tixlegeek/CoolKidsBadge-2024/fw/scripts/createCerts/README.md

# CoolKidsBadge: createCerts

## NAME

CoolKid'sBadge ESP32 SSL Cert generator

## SYNOPSIS

| **ssl_cert_gen.sh**

## DESCRIPTION

Create a set of cert files aimed to be used inside ESP32 HTTPD code.

## FILES

-  **./certs/prvtkey.pem** : private_key

- **./certs/servercert.pem** : certificate

- **./ssl_cert_gen.conf** : Cert configuration file

## ENVIRONMENT

## BUGS

> [!NOTE]
>
> ToDo: Add github repoaddress and bug reporting information

## AUTHOR

@tixlegeek [tixlegeek@cyberpunk.company](mailto:tixlegeek@cyberpunk.company)

## SEE ALSO
