tixlegeek/CoolKidsBadge-2024/hw/CoolKidsBadge_PCB.stl

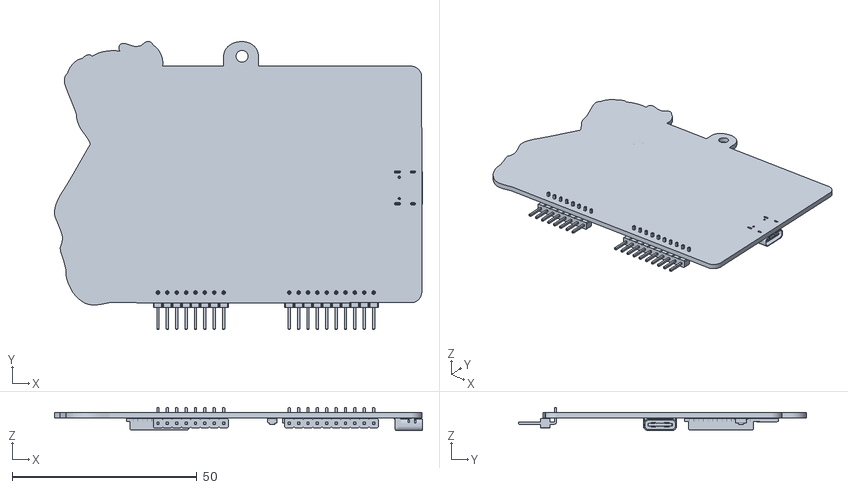
[picture p4: CAD file, 2024-09-17]
hw/CoolKidsBadge_PCB.stl
99.7 x 78.1 x 6.31
