tixlegeek/CoolKidsBadge-2024/hw/kicad_schematics/CIRCLE.kicad_sch

## KiCad design hw/kicad_schematics/CIRCLE.kicad_sch (2024-07-31)

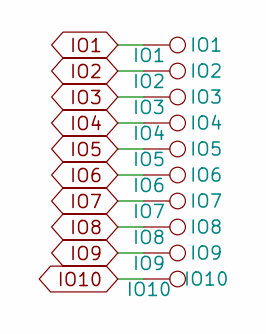
[picture p9: schematic CIRCLE.kicad_sch]

Parts:
IO1: IO1; TestPoint_Pad_D2.0mm
IO2: IO2; TestPoint_Pad_D2.0mm
IO3: IO3; TestPoint_Pad_D2.0mm
IO4: IO4; TestPoint_Pad_D2.0mm
IO5: IO5; TestPoint_Pad_D2.0mm
IO6: IO6; TestPoint_Pad_D2.0mm
IO7: IO7; TestPoint_Pad_D2.0mm
IO8: IO8; TestPoint_Pad_D2.0mm
IO9: IO9; TestPoint_Pad_D2.0mm
IO10: IO10; TestPoint_Pad_D2.0mm

Connections:
IO1: IO1.1
IO2: IO2.1
IO3: IO3.1
IO4: IO4.1
IO5: IO5.1
IO6: IO6.1
IO7: IO7.1
IO8: IO8.1
IO9: IO9.1
IO10: IO10.1
