tixlegeek/CoolKidsBadge-2024/hw/kicad_schematics/CoolKidsBadge.kicad_sch

## KiCad design hw/kicad_schematics/CoolKidsBadge.kicad_sch (2024-07-31)

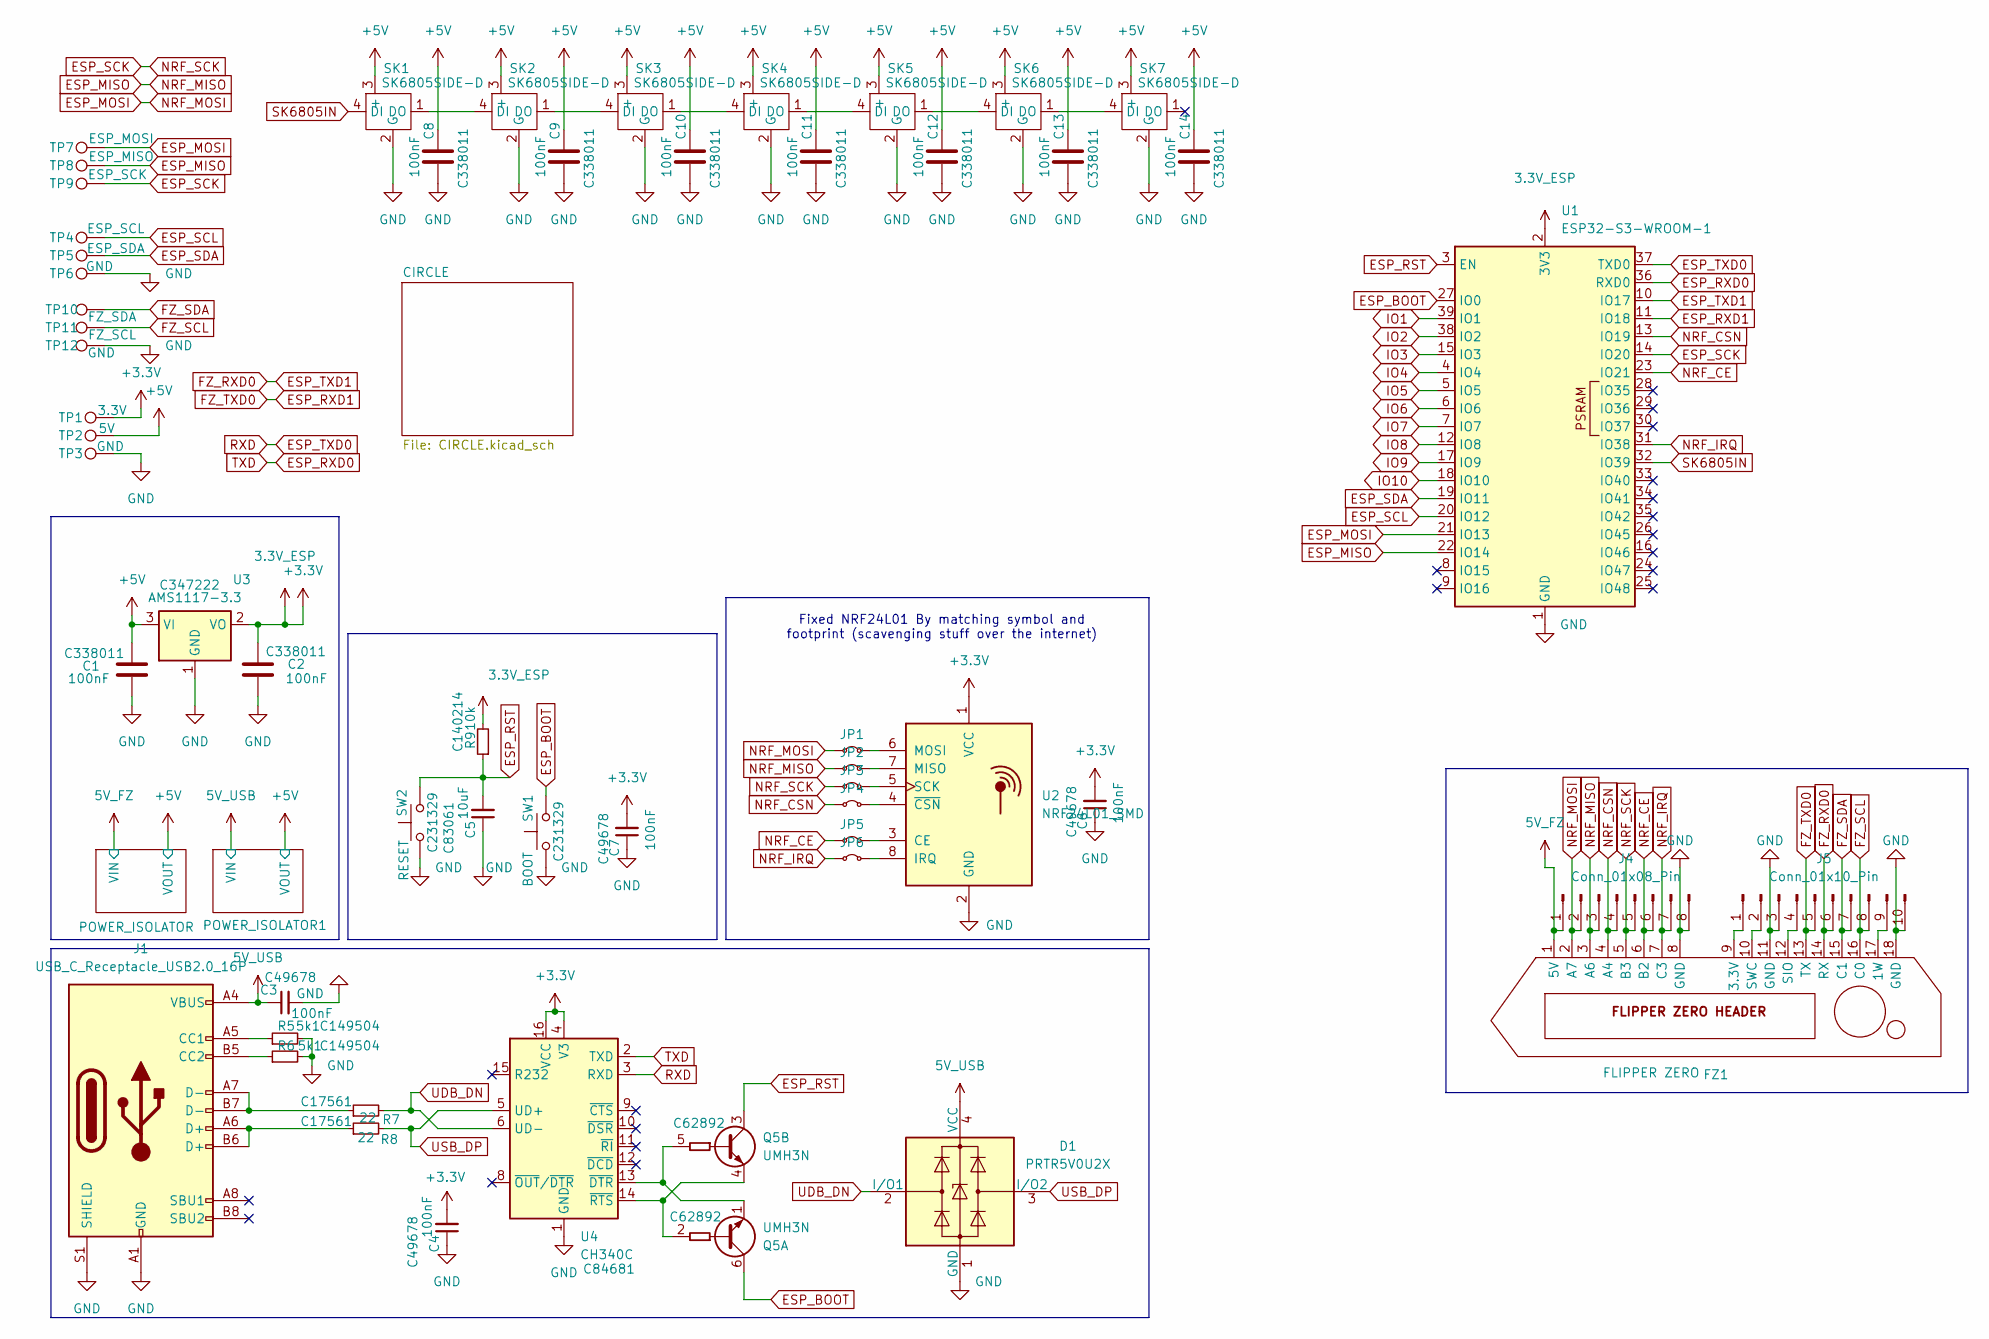
[picture p10: schematic CoolKidsBadge.kicad_sch]

Parts:
C1, C2, C8, C9, C10, C11, C12, C13, C14: 100nF; C_0402_1005Metric; JLCPCB C338011
C3, C4, C6, C7: 100nF; C_0805_2012Metric; JLCPCB C49678
C5: 10uF; C_0805_2012Metric; JLCPCB C83061
D1: PRTR5V0U2X; SOT-143; JLCPCB C5158049
FZ1: FLIPPER ZERO; FLIPPER_ZERO_HEADER
J1: USB_C_Receptacle_USB2.0_16P; USB_C_Receptacle_GCT_USB4105-xx-A_16P_TopMnt_Horizontal
J4: Conn_01x08_Pin; PinHeader_1x08_P2.54mm_Horizontal
J5: Conn_01x10_Pin; PinHeader_1x10_P2.54mm_Horizontal
JP1, JP2, JP3, JP4, JP5, JP6: Jumper_2_Small_Bridged; SolderJumper-2_P1.3mm_Bridged_RoundedPad1.0x1.5mm
Q5: UMH3N; SOT-363_SC-70-6; JLCPCB C62892
R5, R6: 5k1; R_0805_2012Metric; JLCPCB C149504
R7, R8: 22; R_0805_2012Metric; JLCPCB C17561
R9: 10k; R_0805_2012Metric; JLCPCB C140214
SK1, SK2, SK3, SK4, SK5, SK6, SK7: SK6805SIDE-D
SW1: BOOT; SW_SPST_B3U-1000P; JLCPCB C231329
SW2: RESET; SW_SPST_B3U-1000P; JLCPCB C231329
TP1: 3.3V; TestPoint_Pad_D2.5mm
TP2: 5V; TestPoint_Pad_D2.5mm
TP3, TP6, TP12: GND; TestPoint_Pad_D2.5mm
TP4: ESP_SCL; TestPoint_Pad_D2.5mm
TP5: ESP_SDA; TestPoint_Pad_D2.5mm
TP7: ESP_MOSI; TestPoint_Pad_D2.5mm
TP8: ESP_MISO; TestPoint_Pad_D2.5mm
TP9: ESP_SCK; TestPoint_Pad_D2.5mm
TP10: FZ_SDA; TestPoint_Pad_D2.5mm
TP11: FZ_SCL; TestPoint_Pad_D2.5mm
U1: ESP32-S3-WROOM-1
U2: NRF24L01_SMD; NRF24L01-Module-SMD
U3: AMS1117-3.3; SOT-223-3_TabPin2; JLCPCB C347222
U4: CH340C; SOIC-16_3.9x9.9mm_P1.27mm; JLCPCB C84681

Connections:
5V_FZ: FZ1.1 (5V), J4.1
5V_USB: C3.1, D1.4 (VCC), J1.A4 (VBUS), J1.A9 (VBUS), J1.B4 (VBUS), J1.B9 (VBUS)
+3.3V: C2.1, C4.2, C6.2, C7.2, R9.2, TP1.1, U1.2 (3V3), U2.1 (VCC), U3.2 (VO), U4.4 (V3), U4.16 (VCC)
+5V: C1.1, C8.1, C9.1, C10.1, C11.1, C12.1, C13.1, C14.1, SK1.3 (+), SK2.3 (+), SK3.3 (+), SK4.3 (+), SK5.3 (+), SK6.3 (+), SK7.3 (+), TP2.1, U3.3 (VI)
ESP_BOOT: Q5.6 (C1), SW1.2, U1.27 (IO0)
ESP_MISO: FZ1.3 (A6), J4.3, JP2.1 (A), TP8.1, U1.22 (IO14)
ESP_MOSI: FZ1.2 (A7), J4.2, JP1.1 (A), TP7.1, U1.21 (IO13)
ESP_RST: C5.2, Q5.3 (C2), R9.1, SW2.2, U1.3 (EN)
ESP_RXD0: U1.36 (RXD0), U4.2 (TXD)
ESP_RXD1: FZ1.13 (TX), J5.5, U1.11 (IO18)
ESP_SCK: FZ1.5 (B3), J4.5, JP3.1 (A), TP9.1, U1.14 (IO20)
ESP_SCL: TP4.1, U1.20 (IO12)
ESP_SDA: TP5.1, U1.19 (IO11)
ESP_TXD0: U1.37 (TXD0), U4.3 (RXD)
ESP_TXD1: FZ1.14 (RX), J5.6, U1.10 (IO17)
FZ_SCL: FZ1.16 (C0), J5.8, TP11.1
FZ_SDA: FZ1.15 (C1), J5.7, TP10.1
GND: C1.2, C2.2, C3.2, C4.1, C5.1, C6.1, C7.1, C8.2, C9.2, C10.2, C11.2, C12.2, C13.2, C14.2, D1.1 (GND), FZ1.8 (GND), FZ1.11 (GND), FZ1.18 (GND), J1.A1 (GND), J1.A12 (GND), J1.B1 (GND), J1.B12 (GND), J1.S1 (SHIELD), J4.8, J5.3, J5.10, R5.2, R6.2, SK1.2 (G), SK2.2 (G), SK3.2 (G), SK4.2 (G), SK5.2 (G), SK6.2 (G), SK7.2 (G), SW1.1, SW2.1, TP3.1, TP6.1, TP12.1, U1.1 (GND), U1.40 (GND), U1.41 (GND), U2.2 (GND), U3.1 (GND), U4.1 (GND)
IO1: U1.39 (IO1)
IO2: U1.38 (IO2)
IO3: U1.15 (IO3)
IO4: U1.4 (IO4)
IO5: U1.5 (IO5)
IO6: U1.6 (IO6)
IO7: U1.7 (IO7)
IO8: U1.12 (IO8)
IO9: U1.17 (IO9)
IO10: U1.18 (IO10)
NRF_CE: FZ1.6 (B2), J4.6, JP5.1 (A), U1.23 (IO21)
NRF_CSN: FZ1.4 (A4), J4.4, JP4.1 (A), U1.13 (IO19)
NRF_IRQ: FZ1.7 (C3), J4.7, JP6.1 (A), U1.31 (IO38)
unnamed: FZ1.9 (3.3V), J5.1
unnamed: FZ1.10 (SWC), J5.2
unnamed: FZ1.12 (SIO), J5.4
unnamed: FZ1.17 (1W), J5.9
unnamed: J1.A5 (CC1), R5.1
unnamed: J1.A6 (D+), J1.B6 (D+), R8.1
unnamed: J1.A7 (D-), J1.B7 (D-), R7.1
unnamed: J1.B5 (CC2), R6.1
unnamed: JP1.2 (B), U2.6 (MOSI)
unnamed: JP2.2 (B), U2.7 (MISO)
unnamed: JP3.2 (B), U2.5 (SCK)
unnamed: JP4.2 (B), U2.4 (~CSN)
unnamed: JP5.2 (B), U2.3 (CE)
unnamed: JP6.2 (B), U2.8 (IRQ)
unnamed: Q5.1 (E1), Q5.5 (B2), U4.13 (~DTR)
unnamed: Q5.2 (B1), Q5.4 (E2), U4.14 (~RTS)
unnamed: SK1.1 (DO), SK2.4 (DI)
unnamed: SK2.1 (DO), SK3.4 (DI)
unnamed: SK3.1 (DO), SK4.4 (DI)
unnamed: SK4.1 (DO), SK5.4 (DI)
unnamed: SK5.1 (DO), SK6.4 (DI)
unnamed: SK6.1 (DO), SK7.4 (DI)
SK6805IN: SK1.4 (DI), U1.32 (IO39)
UDB_DN: D1.2 (I/O1), R7.2, U4.6 (UD-)
USB_DP: D1.3 (I/O2), R8.2, U4.5 (UD+)

Notes on the sheet:
Fixed NRF24L01 By matching symbol and footprint (scavenging stuff over the internet)
