tixlegeek/CoolKidsBadge-2024/hw/kicad_schematics/POWER_ISOLATOR.kicad_sch

## KiCad design hw/kicad_schematics/POWER_ISOLATOR.kicad_sch (2024-07-31)

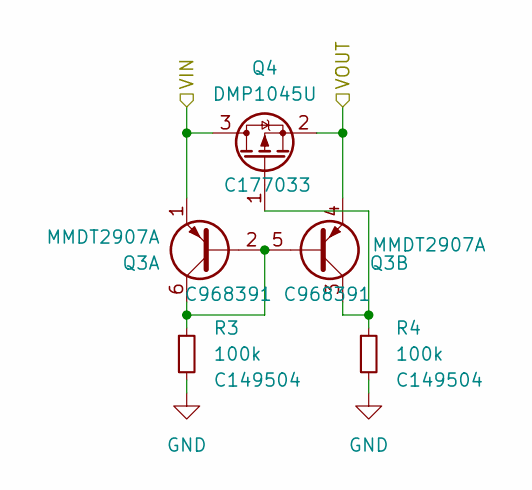
[picture p11: schematic POWER_ISOLATOR.kicad_sch]

Parts:
Q3: MMDT2907A; SOT-363_SC-70-6; JLCPCB C968391
Q4: DMP1045U; SOT-23; JLCPCB C177033
R3, R4: 100k; R_0805_2012Metric; JLCPCB C149504

Connections:
GND: R3.2, R4.2
unnamed: Q3.2 (B1), Q3.5 (B2), Q3.6 (C1), R3.1
unnamed: Q3.3 (C2), Q4.1 (G), R4.1
VIN: Q3.1 (E1), Q4.3 (D)
VOUT: Q3.4 (E2), Q4.2 (S)
