tixlegeek/CoolKidsBadge-2024/fw/esp32/main/board.h

/** -------------------------------------------------------
 *  ▞▚ ▚▗▘▛▚ ▛▀ ▛▚ ▛▚ ▌▐ ▙▐ ▌▞  ▞▚ ▞▚ ▙▟ ▛▚ ▞▚ ▙▐ ▚▗▘
 *  ▌▗  ▌ ▛▚ ▛  ▛▚ ▛▘ ▌▐ ▌▜ ▛▖  ▌▗ ▌▐ ▌▐ ▛▘ ▛▜ ▌▜  ▌
 *  ▝▘  ▘ ▀▘ ▀▀ ▘▝ ▘  ▝▘ ▘▝ ▘▝ ▘▝▘ ▝▘ ▘▝ ▘  ▘▝ ▘▝  ▘
 * Copyright© 2024 - Cyberpunk.Company - GPLv3
 * This program is free software
 * See LICENSE.txt - https://cyberpunk.company/tixlegeek
 * -------------------------------------------------------**/

#ifndef _BOARD_H_
#define _BOARD_H_

#include "esp_log.h"

#include "driver/i2c_master.h"

#define BOARD_I2C_SDA 11
#define BOARD_I2C_SCL 12

#define BOARD_LED_NUMBERS 7
#define BOARD_LED_GPIO_NUM 39

#define LED_STRIP_RESOLUTION_HZ 10000000

#define I2C_MASTER_NUM I2C_NUM_0
#define I2C_MASTER_FREQ_HZ 400000   /*!< I2C master clock frequency */
#define I2C_MASTER_TX_BUF_DISABLE 0 /*!< I2C master doesn't need buffer */
#define I2C_MASTER_RX_BUF_DISABLE 0 /*!< I2C master doesn't need buffer */
#define I2C_MASTER_TIMEOUT_MS 500
#define I2C_MASTER_FREQ_HZ
#define I2C_MAX_REG_READ 1024

#endif /* end of include guard: _BOARD_H_ */
