tixlegeek/CoolKidsBadge-2024/fw/esp32/main/led.c

/** -------------------------------------------------------
 *  ▞▚ ▚▗▘▛▚ ▛▀ ▛▚ ▛▚ ▌▐ ▙▐ ▌▞  ▞▚ ▞▚ ▙▟ ▛▚ ▞▚ ▙▐ ▚▗▘
 *  ▌▗  ▌ ▛▚ ▛  ▛▚ ▛▘ ▌▐ ▌▜ ▛▖  ▌▗ ▌▐ ▌▐ ▛▘ ▛▜ ▌▜  ▌
 *  ▝▘  ▘ ▀▘ ▀▀ ▘▝ ▘  ▝▘ ▘▝ ▘▝ ▘▝▘ ▝▘ ▘▝ ▘  ▘▝ ▘▝  ▘
 * Copyright© 2024 - Cyberpunk.Company - GPLv3
 * This program is free software
 * See LICENSE.txt - https://cyberpunk.company/tixlegeek
 * -------------------------------------------------------**/

#include "led.h"
#include "coolkids.h"
static const char *TAG = "LED";
// Text labels
const uint8_t fire_palette[] = {
  0xff, 0xff, 0xff,
  0xff, 0xff, 0xfb,
  0xff, 0xff, 0xf7,
  0xff, 0xff, 0xf3,
  0xff, 0xff, 0xef,
  0xff, 0xff, 0xeb,
  0xff, 0xff, 0xe7,
  0xff, 0xff, 0xe3,
  0xff, 0xff, 0xdf,
  0xff, 0xff, 0xdb,
  0xff, 0xff, 0xd7,
  0xff, 0xff, 0xd3,
  0xff, 0xff, 0xcf,
  0xff, 0xff, 0xcb,
  0xff, 0xff, 0xc7,
  0xff, 0xff, 0xc3,
  0xff, 0xff, 0xbf,
  0xff, 0xff, 0xbb,
  0xff, 0xff, 0xb7,
  0xff, 0xff, 0xb3,
  0xff, 0xff, 0xaf,
  0xff, 0xff, 0xab,
  0xff, 0xff, 0xa7,
  0xff, 0xff, 0xa3,
  0xff, 0xff, 0x9f,
  0xff, 0xff, 0x9b,
  0xff, 0xff, 0x97,
  0xff, 0xff, 0x93,
  0xff, 0xff, 0x8f,
  0xff, 0xff, 0x8b,
  0xff, 0xff, 0x87,
  0xff, 0xff, 0x83,
  0xff, 0xff, 0x7f,
  0xff, 0xff, 0x7b,
  0xff, 0xff, 0x77,
  0xff, 0xff, 0x73,
  0xff, 0xff, 0x6f,
  0xff, 0xff, 0x6b,
  0xff, 0xff, 0x67,
  0xff, 0xff, 0x63,
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
};
// Names of the animations
const char *const led_cb_name[] = {"rainbow", "green",    "sp4rkle",
                                   "s3cr3t",  "sp1n2W1n", "F1r3"};

// Callbacks
void *led_cb_array[] = {led_rainbow_cb, led_green_cb,    led_sparkle_cb,
                        led_s3cre3t_cb, led_sp1n2W1n_cb, led_fire_cb};

/**
  led_task
  @brief Task that updates the LEDs
  @parms pvParameter -> rgb_led_ctx: RGB Led structure
  @return -
*/
void led_task(void *pvParameter) {
  rgb_led_ctx_t *rgb_led_ctx = (rgb_led_ctx_t *)pvParameter;
  uint32_t t = 0;
  uint8_t shader;
  esp_err_t err;
  err = led_get_saved(&shader);
  if (err != ESP_OK) {
    ESP_LOGE(TAG, "[x] No previous shader configuration set.");
    shader = 0;
  }
  ESP_LOGI(TAG, "[+] LED Task started.");
  ESP_LOGI(TAG, "[+] LED Task calling %s (%d)", led_cb_name[shader], shader);
  while (1) {
    t++;
    led_shader(t, rgb_led_ctx);
    vTaskDelay(10 / portTICK_PERIOD_MS);
  }

  ESP_LOGE(TAG, "[x] LED Task exited.");
}

/**
  led_init
  @brief Initialize RMT and sets up the SK6805 LED chain
  @parms rgb_led_ctx: RGB Led structure
  @return -
*/
void led_init(rgb_led_ctx_t *rgb_led_ctx) {
  uint8_t shader;
  esp_err_t err;
  rgb_led_ctx->tx_chan_config.clk_src =
      RMT_CLK_SRC_DEFAULT; // select source clock
  rgb_led_ctx->tx_chan_config.gpio_num = BOARD_LED_GPIO_NUM;
  rgb_led_ctx->tx_chan_config.mem_block_symbols =
      64; // increase the block size can make the LED less flickering
  rgb_led_ctx->tx_chan_config.resolution_hz = LED_STRIP_RESOLUTION_HZ;
  rgb_led_ctx->tx_chan_config.trans_queue_depth =
      4; // set the number of transactions that can be pending in the background

  rgb_led_ctx->tx_config.loop_count = 0;

  rgb_led_ctx->led_chan = 0;
  rgb_led_ctx->led_encoder = NULL;

  err = led_get_saved(&shader);
  if (err != ESP_OK) {
    ESP_LOGE(TAG, "[x] No previous shader configuration set.");
    shader = 0;
  }

  rgb_led_ctx->led_cb = led_cb_array[shader];

  ESP_ERROR_CHECK(
      rmt_new_tx_channel(&rgb_led_ctx->tx_chan_config, &rgb_led_ctx->led_chan));
  ESP_LOGI(TAG, "[+] Install led strip encoder");

  led_strip_encoder_config_t encoder_config = {
      .resolution = LED_STRIP_RESOLUTION_HZ,
  };

  rgb_led_ctx->led_encoder = NULL;

  ESP_ERROR_CHECK(
      rmt_new_led_strip_encoder(&encoder_config, &rgb_led_ctx->led_encoder));

  ESP_LOGI(TAG, "[+] Enable RMT TX channel");
  ESP_ERROR_CHECK(rmt_enable(rgb_led_ctx->led_chan));
}

/**
  led_commit
  @brief Sends data to the LEDs
  @parms rgb_led_ctx: RGB Led structure
  @return -
*/
void led_commit(rgb_led_ctx_t *rgb_led_ctx, uint8_t *led_strip_pixels) {
  ESP_ERROR_CHECK(rmt_transmit(rgb_led_ctx->led_chan, rgb_led_ctx->led_encoder,
                               led_strip_pixels, BOARD_LED_NUMBERS * 3,
                               &rgb_led_ctx->tx_config));
  ESP_ERROR_CHECK(rmt_tx_wait_all_done(rgb_led_ctx->led_chan, portMAX_DELAY));
}

/**
  led_update
  @brief alias of commit
  @parms rgb_led_ctx: RGB Led structure
  @return -
*/
void led_update(rgb_led_ctx_t *rgb_led_ctx) {
  led_commit(rgb_led_ctx, rgb_led_ctx->led_array);
}

/**

*/
void led_rainbow_cb(uint16_t t, uint8_t ledindex, void *ctx) {
  rgb_led_ctx_t *rgb_led_ctx = (rgb_led_ctx_t *)ctx;
  uint8_t r;
  uint8_t g;
  uint8_t b;
  led_strip_hsv2rgb((t + ledindex * (90 / BOARD_LED_NUMBERS)) % 360, 100, 100,
                    &r, &g, &b);
  rgb_led_ctx->led_array[ledindex * 3 + 0] = g;
  rgb_led_ctx->led_array[ledindex * 3 + 1] = r;
  rgb_led_ctx->led_array[ledindex * 3 + 2] = b;
}

/**

*/
char secretStr[] = CKB_SECRET_PHRASE;

void led_s3cre3t_cb(uint16_t t, uint8_t ledindex, void *ctx) {
  rgb_led_ctx_t *rgb_led_ctx = (rgb_led_ctx_t *)ctx;
  uint16_t offset = t >> 7;
  uint8_t i = 0;
  uint8_t strLen = strlen(secretStr);
  uint8_t strChar = secretStr[offset % strLen];
  uint8_t color = ((strChar >> ledindex) & 0x01) ? 0xFF : 0x00;

  if ((offset % strLen == 0) && (ledindex == 6)) {
    for (i = 0; i < 7; i++) {
      rgb_led_ctx->led_array[i * 3 + 0] = ((t >> 1) % 2 == 0) ? 0xff : 0;
      rgb_led_ctx->led_array[i * 3 + 1] = 0;
      rgb_led_ctx->led_array[i * 3 + 2] = ((t >> 1) % 2 == 0) ? 0x27 : 0;
    }

  } else {
    rgb_led_ctx->led_array[ledindex * 3 + 0] = 0;
    rgb_led_ctx->led_array[ledindex * 3 + 1] = color & 0xff;
    rgb_led_ctx->led_array[ledindex * 3 + 2] = color & 0x27;
  }
}

/**

*/
void led_sp1n2W1n_cb(uint16_t t, uint8_t ledindex, void *ctx) {
  rgb_led_ctx_t *rgb_led_ctx = (rgb_led_ctx_t *)ctx;
  uint8_t r;
  uint8_t g;
  uint8_t b;
  led_strip_hsv2rgb(((t >> 4) * (90 / BOARD_LED_NUMBERS)) % 360, 100, 100, &r,
                    &g, &b);
  bool chekLed = (((ledindex + (t >> 2)) % BOARD_LED_NUMBERS) == 0);
  if (chekLed) {
    rgb_led_ctx->led_array[ledindex * 3 + 0] = g;
    rgb_led_ctx->led_array[ledindex * 3 + 1] = r;
    rgb_led_ctx->led_array[ledindex * 3 + 2] = b;
  } else {
    rgb_led_ctx->led_array[ledindex * 3 + 0] = 0;
    rgb_led_ctx->led_array[ledindex * 3 + 1] = 0;
    rgb_led_ctx->led_array[ledindex * 3 + 2] = 0;
  }
}

/**

*/
void led_fire_cb(uint16_t t, uint8_t ledindex, void *ctx) {
  rgb_led_ctx_t *rgb_led_ctx = (rgb_led_ctx_t *)ctx;
  uint8_t rand = t ^ ledindex;
  rand ^= (rand << 3);
  rand ^= rand >> 5;
  rand ^= rand << 4;
  uint8_t colorindex = (t + ledindex + rand) % 255;
  rgb_led_ctx->led_array[ledindex * 3 + 0] = fire_palette[colorindex*3+1];
  rgb_led_ctx->led_array[ledindex * 3 + 1] = fire_palette[colorindex*3+0];
  rgb_led_ctx->led_array[ledindex * 3 + 2] = fire_palette[colorindex*3+2];
}

/**

*/
void led_sparkle_cb(uint16_t t, uint8_t ledindex, void *ctx) {
  rgb_led_ctx_t *rgb_led_ctx = (rgb_led_ctx_t *)ctx;
  uint8_t rand = t ^ ledindex;
  rand ^= (rand << 3);
  rand ^= rand >> 5;
  rand ^= rand << 4;
  rgb_led_ctx->led_array[ledindex * 3 + 0] = rand + (rand << 8) + (rand << 16);
  rgb_led_ctx->led_array[ledindex * 3 + 1] = rand + (rand << 8) + (rand << 16);
  rgb_led_ctx->led_array[ledindex * 3 + 2] = rand + (rand << 8) + (rand << 16);
}
/**

*/
void led_green_cb(uint16_t t, uint8_t ledindex, void *ctx) {
  rgb_led_ctx_t *rgb_led_ctx = (rgb_led_ctx_t *)ctx;
  uint8_t rand = t ^ ledindex;
  rand ^= (rand << 3);
  rand ^= rand >> 5;
  rand ^= rand << 4;
  double factor = ((double)rand / 255);
  uint8_t g = (uint8_t)(0xff * factor);
  uint8_t b = (uint8_t)(0);
  uint8_t r = (uint8_t)(0x27 * factor);
  rgb_led_ctx->led_array[ledindex * 3 + 0] = g;
  rgb_led_ctx->led_array[ledindex * 3 + 1] = r;
  rgb_led_ctx->led_array[ledindex * 3 + 2] = b;
}

/**

*/
void led_shader(uint16_t t, rgb_led_ctx_t *rgb_led_ctx) {
  led_cb_t led_cb = rgb_led_ctx->led_cb;
  for (int j = 0; j < BOARD_LED_NUMBERS; j++) {
    led_cb(t, j, rgb_led_ctx);
  }
  led_update(rgb_led_ctx);
}

/**
 * @brief Simple helper function, converting HSV color space to RGB color space
 *
 * Wiki: https://en.wikipedia.org/wiki/HSL_and_HSV
 *
 */
void led_strip_hsv2rgb(uint32_t h, uint32_t s, uint32_t v, uint32_t *r,
                       uint32_t *g, uint32_t *b) {
  h %= 360; // h -> [0,360]
  uint32_t rgb_max = v * 2.55f;
  uint32_t rgb_min = rgb_max * (100 - s) / 100.0f;
  uint32_t i = h / 60;
  uint32_t diff = h % 60;
  // RGB adjustment amount by hue
  uint32_t rgb_adj = (rgb_max - rgb_min) * diff / 60;

  switch (i) {
  case 0:
    *r = rgb_max;
    *g = rgb_min + rgb_adj;
    *b = rgb_min;
    break;
  case 1:
    *r = rgb_max - rgb_adj;
    *g = rgb_max;
    *b = rgb_min;
    break;
  case 2:
    *r = rgb_min;
    *g = rgb_max;
    *b = rgb_min + rgb_adj;
    break;
  case 3:
    *r = rgb_min;
    *g = rgb_max - rgb_adj;
    *b = rgb_max;
    break;
  case 4:
    *r = rgb_min + rgb_adj;
    *g = rgb_min;
    *b = rgb_max;
    break;
  default:
    *r = rgb_max;
    *g = rgb_min;
    *b = rgb_max - rgb_adj;
    break;
  }
}
