tixlegeek/CoolKidsBadge-2024/fw/esp32/main/coolkids.h

#ifndef _COOLKIDS_H
#define _COOLKIDS_H

#include "handlers/handlers.h"

#define CKB_HOSTNAME "coolkid"
#define CKB_STA_HOSTNAME CKB_HOSTNAME
#define CKB_AP_HOSTNAME CKB_HOSTNAME
#define CKB_FIRMWARE_VERSION "1.0.2"
#define CKB_SCAN_LIST_SIZE 10
#define CKB_AP_PASSWORD "camembert"
#define CKB_AP_WIFI_CHANNEL 6
#define CKB_AP_MAX_STA_CONN 10
#define CKB_SECRET_PHRASE "CACA"

#endif /* end of include guard: _COOLKIDS_H */
