tixlegeek/CoolKidsBadge-2024/fw/esp32/main/handlers/post/ota.c

/** -------------------------------------------------------
 *  ▞▚ ▚▗▘▛▚ ▛▀ ▛▚ ▛▚ ▌▐ ▙▐ ▌▞  ▞▚ ▞▚ ▙▟ ▛▚ ▞▚ ▙▐ ▚▗▘
 *  ▌▗  ▌ ▛▚ ▛  ▛▚ ▛▘ ▌▐ ▌▜ ▛▖  ▌▗ ▌▐ ▌▐ ▛▘ ▛▜ ▌▜  ▌
 *  ▝▘  ▘ ▀▘ ▀▀ ▘▝ ▘  ▝▘ ▘▝ ▘▝ ▘▝▘ ▝▘ ▘▝ ▘  ▘▝ ▘▝  ▘
 * Copyright© 2024 - Cyberpunk.Company - GPLv3
 * This program is free software
 * See LICENSE.txt - https://cyberpunk.company/tixlegeek
 * -------------------------------------------------------**/
#include "../handlers.h"
static const char *TAG = "POST_OTA";

esp_err_t update_post_handler(httpd_req_t *req)
{
    char buf[1000];
    esp_ota_handle_t ota_handle;
    int remaining = req->content_len;

    const esp_partition_t *ota_partition = esp_ota_get_next_update_partition(NULL);
    ESP_ERROR_CHECK(esp_ota_begin(ota_partition, OTA_SIZE_UNKNOWN, &ota_handle));

    while (remaining > 0)
    {
        int recv_len = httpd_req_recv(req, buf, MIN(remaining, sizeof(buf)));

        // Timeout Error: Just retry
        if (recv_len == HTTPD_SOCK_ERR_TIMEOUT)
        {
            continue;
            // Serious Error: Abort OTA
        }
        else if (recv_len <= 0)
        {
            httpd_resp_send_err(req, HTTPD_500_INTERNAL_SERVER_ERROR, "Protocol Error");
            return ESP_FAIL;
        }

        // Successful Upload: Flash firmware chunk
        if (esp_ota_write(ota_handle, (const void *)buf, recv_len) != ESP_OK)
        {
            httpd_resp_send_err(req, HTTPD_500_INTERNAL_SERVER_ERROR, "Flash Error");
            return ESP_FAIL;
        }

        remaining -= recv_len;
    }

    // Validate and switch to new OTA image and reboot
    if (esp_ota_end(ota_handle) != ESP_OK || esp_ota_set_boot_partition(ota_partition) != ESP_OK)
    {
        httpd_resp_send_err(req, HTTPD_500_INTERNAL_SERVER_ERROR, "Validation / Activation Error");
        return ESP_FAIL;
    }

    httpd_resp_sendstr(req, "F1rm4ar3 upd4t3 c0mpl3t3, r3b00ting n0w!\n");

    vTaskDelay(500 / portTICK_PERIOD_MS);
    esp_restart();

    return ESP_OK;
}
