tixlegeek/CoolKidsBadge-2024/(commit log)

2024-07-31 added kicad files and libraries
    [CIRCLE.kicad_sch, CoolKidsBadge.kicad_sch, POWER_ISOLATOR.kicad_sch]
2024-07-31 Added PDF format schematics
2024-07-31 Filled infos on Schematics
    [CIRCLE.kicad_sch, CoolKidsBadge.kicad_sch, POWER_ISOLATOR.kicad_sch]
2024-09-17 Add 3D Model
    [CoolKidsBadge_PCB.stl]
